LEP-PEA-EPUSP/OpenSourcePowerElectronics-HW-ProcessingModule-2026/README.md

# OpenSourcePowerElectronics-HW-ProcessingModule-2026

This repository contains the manuals, schematics and layout files, as well the testing programas necessary to build and use the processing module of platform
