LEP-PEA-EPUSP/OpenSourcePowerElectronics-HW-ProcessingModule-2026/(list of files, drawings)

Other design files:
Schematics and Layouts/moduloProcessamento.PrjPcb
Schematics and Layouts/optoacoplador.PcbLib
Schematics and Layouts/optoacoplador.SchLib
Schematics and Layouts/PCB1.PcbDoc
Schematics and Layouts/S bus (5.775 X 3.30 inches).schdoc
