LEP-PEA-EPUSP/OpenSourcePowerElectronics-HW-ProcessingModule-2026/Others/Optos-20230306T230931Z-001/Optos/Core/Src/main.c

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
/* Includes ------------------------------------------------------------------*/
#include "main.h"
#include "usb_host.h"

I2S_HandleTypeDef hi2s3;

SPI_HandleTypeDef hspi1;

void SystemClock_Config(void);
static void MX_GPIO_Init(void);
static void MX_I2S3_Init(void);
static void MX_SPI1_Init(void);
void MX_USB_HOST_Process(void);

/**
  * @brief  The application entry point.
  * @retval int
  */
int main(void)
{
  /* MCU Configuration--------------------------------------------------------*/

  /* Reset of all peripherals, Initializes the Flash interface and the Systick. */
  HAL_Init();

  /* Configure the system clock */
  SystemClock_Config();

  /* Initialize all configured peripherals */
  MX_GPIO_Init();
  MX_I2S3_Init();
  MX_SPI1_Init();
  MX_USB_HOST_Init();
  /* USER CODE BEGIN 2 */
  //Reset all pins



  //Optocoupler 1
  HAL_GPIO_WritePin(GPIOB, GPIO_PIN_6, GPIO_PIN_RESET);

  /* USER CODE END 2 */

  /* Infinite loop */
  /* USER CODE BEGIN WHILE */
  while (1)
  {
	  // Vers�o para testes dos Optos!
	  ///////////////////////////////////////////////////////////////////

	  int timer = 2000; //define o tempo dos delays

	  HAL_Delay(timer); //espera unidades de tempo
	  HAL_GPIO_WritePin(GPIOB, GPIO_PIN_6, GPIO_PIN_SET); //Set PB6
	  HAL_Delay(timer); //espera unidades de tempo
	  HAL_GPIO_WritePin(GPIOB, GPIO_PIN_6, GPIO_PIN_RESET); //Reset PB6


	  //espera 5000 unidades de tempo
	  HAL_Delay(5000);

    /* USER CODE END WHILE */
    MX_USB_HOST_Process();

    /* USER CODE BEGIN 3 */
  }
  /* USER CODE END 3 */
}

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
