LEP-PEA-EPUSP/OpenSourcePowerElectronics-HW-ProcessingModule-2026/(notices)

Notices in the files:
Others/Optos-20230306T230931Z-001/Optos/Core/Inc/main.h:
Copyright (c) 2022 STMicroelectronics.
All rights reserved.
This software is licensed under terms that can be found in the LICENSE file
Others/Optos-20230306T230931Z-001/Optos/Core/Src/main.c:
© Copyright (c) 2021 STMicroelectronics.
This software component is licensed by ST under BSD 3-Clause license,
the "License"; You may not use this file except in compliance with the
License. You may obtain a copy of the License at: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
Others/Teste-adc-20230306T230913Z-001/Teste-adc/Core/Src/main.c:
(C) COPYRIGHT STMicroelectronics *****END OF FILE
